smookie77/esp32PhoneV2/HARDWARE/pcb/BOM_Mainboard_PCB4_2026-01-02.csv

Quantity | Designator | Footprint | Value | Manufacturer Part | Manufacturer | Supplier Part | Supplier
8 | BOOT,GSM_DBG_RX,GSM_DBG_TX,RST,TP_BOOT,TP_DN,TP_DP,TP_VBUS | tp05R
17 | C11,C12,C31,C43,C45,C47,C51,C61,C81,C82,C83,C91,C92,C93,C94,C143,C145 | C0603 | 10uF | CL10A106KP8NNNC | SAMSUNG(三星) | C19702 | LCSC
10 | C13,C21,C22,C41,C42,C44,C46,C48,C49,C144 | C0603 | 1uF | CL10B105KA8NNNC | SAMSUNG(三星) | C29936 | LCSC
1 | C32 | C0603 | 100nF | CL10B104KC8NNNC | SAMSUNG(三星) | C15725 | LCSC
2 | C141,C142 | CAP-SMD_L7.3-W4.3-FD | 220uF | TPSD227K010R0100 | Kyocera AVX | C2764452 | LCSC
1 | CN2 | CONN-SMD_2P-P2.00_PH2.0-SPWB |  | PH-2P卧贴 | BOOMELE(博穆精密) | C47647 | LCSC
1 | H1 | HDR-TH_8P-P2.54-V-M
1 | H2 | HDR-TH_2P-P2.54-V-M-1
1 | H3 | HDR-TH_18P-P2.54-V-F-R2-C9-S2.54-1
5 | L91,L141,L142,L143,L144 | L1206 | 2.2uH | MGFL3216F2R2MT-LF | microgate(麦捷科技) | C486337 | LCSC
1 | LCD | HDR-TH_4P-P2.54-V-M
1 | LDO1 | SOT-23-5_L3.0-W1.7-P0.95-LS2.8-BL |  | ME6211C33M5G-N | MICRONE(南京微盟) | C82942 | LCSC
1 | R31 | R0603 | 680kΩ | RT0603BRE07680KL | YAGEO(国巨) | C862257 | LCSC
3 | R32,R36,R61 | R0603 | 1MΩ | RC0603FR-071ML | YAGEO(国巨) | C105578 | LCSC
5 | R41,R42,R81,R84,R85 | R0603 | 10kΩ | RT0603BRD0710KL | YAGEO(国巨) | C95204 | LCSC
3 | R43,R44,R83 | R0603 | 2kΩ | RC0603FR-072KL | YAGEO(国巨) | C105576 | LCSC
1 | R82 | R0603 | 560Ω | RT0603BRD07560RL | YAGEO(国巨) | C861472 | LCSC
1 | RF1 | IPEX-SMD_4P-L1.7-W1.7-LS2.0-L-4 | 6GHz | IPEX-3 | HanElectricity(瀚源) | C47986641 | LCSC
1 | SW1 | SW-TH_G-SWITCH_SK-12F04-G050 |  | SK-12F04-G050 | G-Switch(品赞) | C2848876 | LCSC
1 | TF1 | TF-SMD_TF-CARD-H1.8 |  | TF-CARD H1.8 | SHOU HAN(首韩) | C7529389 | LCSC
1 | U1 | WIRELM-SMD_ESP32-S3-WROOM-1U |  | ESP32-S3-WROOM-1U-N16R8 | ESPRESSIF(乐鑫) | C3013946 | LCSC
1 | U3 | TQFN-16_L3.0-W3.0-P0.50-BL-EP1.5 |  | MAX98357AETE+T | ADI(亚德诺)/MAXIM(美信) | C910544 | LCSC
1 | U4 | WQFN-20_L3.0-W3.0-P0.50-TL-EP1.4 |  | PCM1809IRTER | TI(德州仪器) | C38558044 | LCSC
1 | U5 | TSSOP-20_L6.5-W4.4-P0.65-LS6.4-BL |  | TXS0108EPWR | TI(德州仪器) | C17206 | LCSC
1 | U6 | SIM-SMD_XDSM-0240-2183B |  | XDSM-0240-2183B | LX(连欣科技) | C7498090 | LCSC
1 | U7 | USB-C-SMD_G-SWITCH_GT-USB-7010ASV |  | GT-USB-7010ASV | G-Switch(品赞) | C2988369 | LCSC
1 | U8 | MSOP-10_L3.0-W3.0-P0.50-LS5.0-BL-EP |  | BQ24090DGQR | TI(德州仪器) | C43306 | LCSC
1 | U14 | LCC-LAG_L17.6-W15.7_A7680C |  | A7680C-LANV | SIMCOM(芯讯通无线科技) | C5381968 | LCSC
