smookie77/esp32PhoneV2/HARDWARE/pcb/BOM_Keyboard_PCB3_2026-01-02.csv

No. | Quantity | Comment | Designator | Footprint | Value | Manufacturer Part | Manufacturer | Supplier Part | Supplier
1 | 21 | YZA-072-10.0 | BTN1,BTN2,BTN3,BTN4,BTN5,BTN6,BTN7,BTN8,BTN9,BTN10,BTN11,BTN12,BTN13,BTN14,BTN15,BTN16,BTN17,BTN18,BTN19,BTN20,BTN21 | SW-SMD_4P-L6.0-W6.0-P4.5-LS9.0-YZA-072-10.0 |  | YZA-072-10.0 | YIZHI(逸致) | C49108668 | LCSC
2 | 1 | 100nF | C21 | C0603 | 100nF | CL10B104KB8NNNC | SAMSUNG(三星) | C1591 | LCSC
3 | 1 | 10uF | C22 | C0603 | 10uF | CL10A106KP8NNNC | SAMSUNG(三星) | C19702 | LCSC
4 | 3 | 1uF | C31,C35,C36 | C0603 | 1uF | CL10B105KA8NNNC | SAMSUNG(三星) | C29936 | LCSC
5 | 3 | 33pF | C32,C33,C34 | C0603 | 33pF | CL10C330JB8NNNC | SAMSUNG(三星) | C1663 | LCSC
6 | 1 | PZ254V-11-08P | H1 | HDR-TH_8P-P2.54-V-M |  | PZ254V-11-08P | XFCN(兴飞) | C492407 | LCSC
7 | 3 | ST-1112RA-L | SW1,SW2,SW3 | SW-SMD_ST-1112RA-L |  | ST-1112RA-L | RISHENG(日昇) | C589179 | LCSC
8 | 1 | TCA9555RTWR | U2 | VFQFPN-24_L4.0-W4.0-P0.50-BL-EP2.8 |  | TCA9555RTWR | TI(德州仪器) | C140277 | LCSC
9 | 1 | ICS-40720 | U3 | SMD_4P-P0.88_ICS-40720 |  | ICS-40720 | TDK InvenSense(应美盛) | C3171779 | LCSC
