smookie77/esp32PhoneV2/HARDWARE/pcb/Keyboard_schematic.pdf

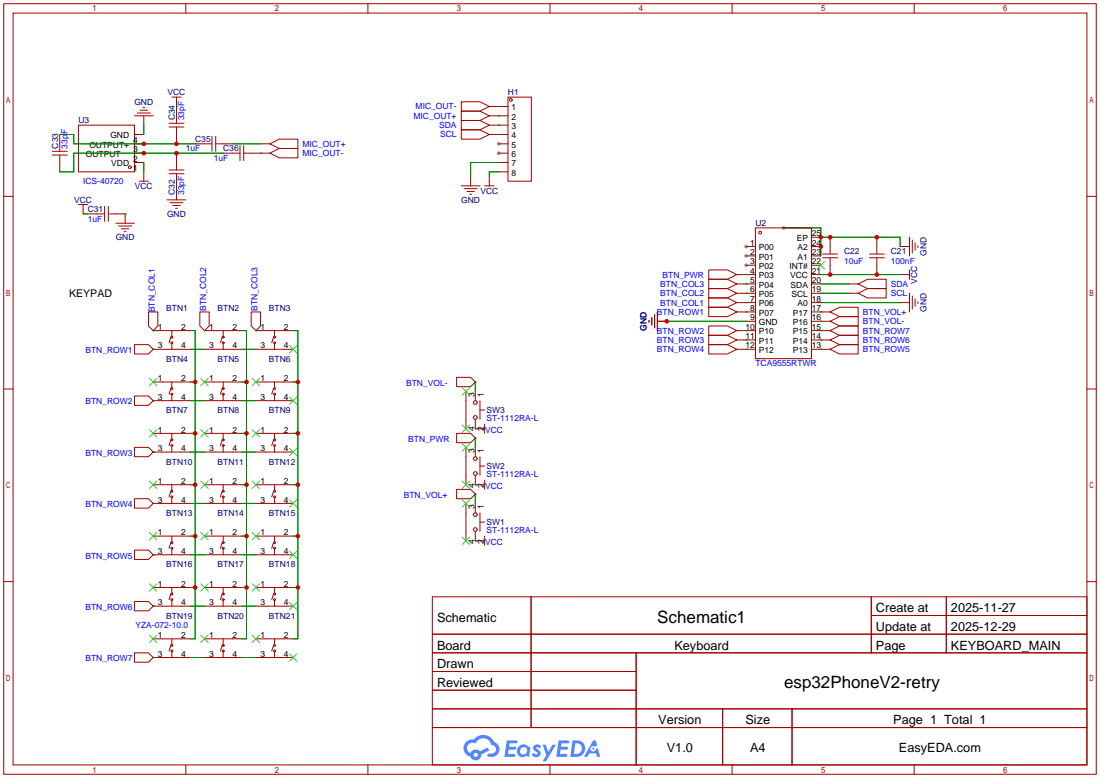
[picture p1: page 1]

Schematic | Schematic1 | Create at | 2025-11-27

Update at | 2025-12-29

Board | Keyboard | Page | KEYBOARD_MAIN
Drawn | | esp32PhoneV2-retry
Reviewed

Version | Size | Page 1 Total 1
V1.0 | A4 | EasyEDA.com
