smookie77/esp32PhoneV2/HARDWARE/pcb/Mainboard_schematics.pdf

IO0 27 IO35 28 IO36 29 IO37 30 IO38 31 IO39 32 IO40 33 IO41 34 IO42 35 RXD0 36 TXD0 37 IO2 38 IO1 39 GND 40

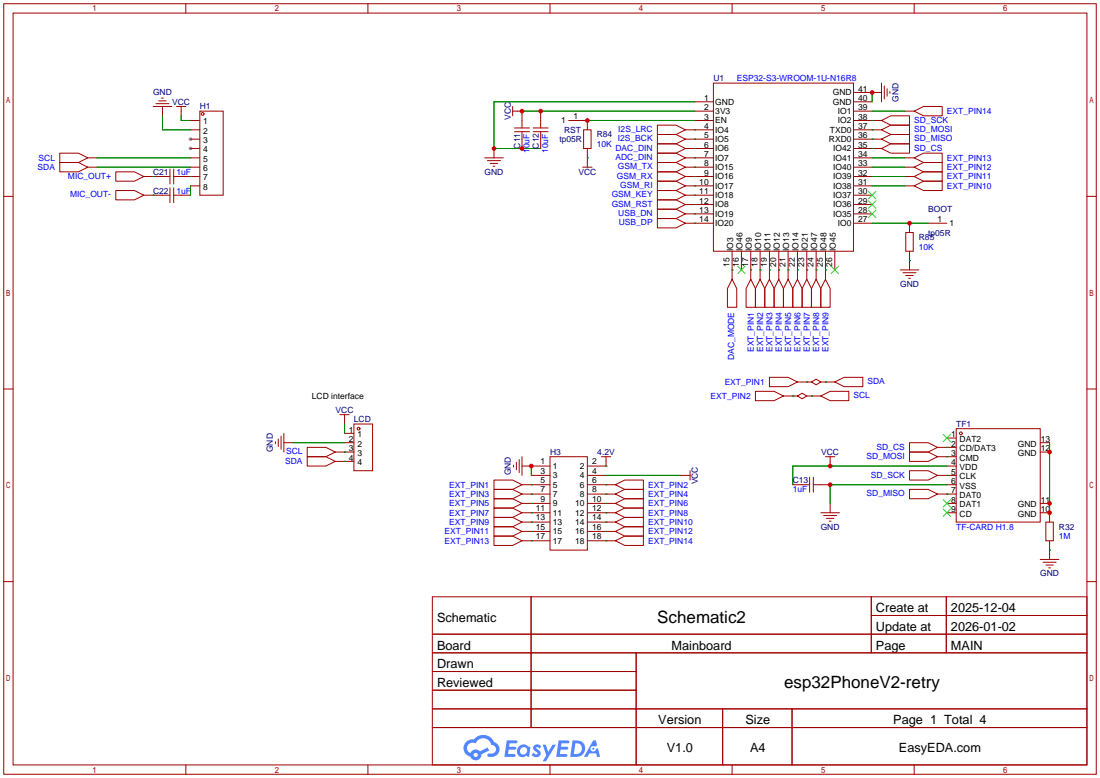
[picture p2: page 1]

Schematic | Schematic2 | Create at | 2025-12-04

Update at | 2026-01-02

Board | Mainboard | Page | MAIN
Drawn | | esp32PhoneV2-retry
Reviewed

Version | Size | Page 1 Total 4
V1.0 | A4 | EasyEDA.com

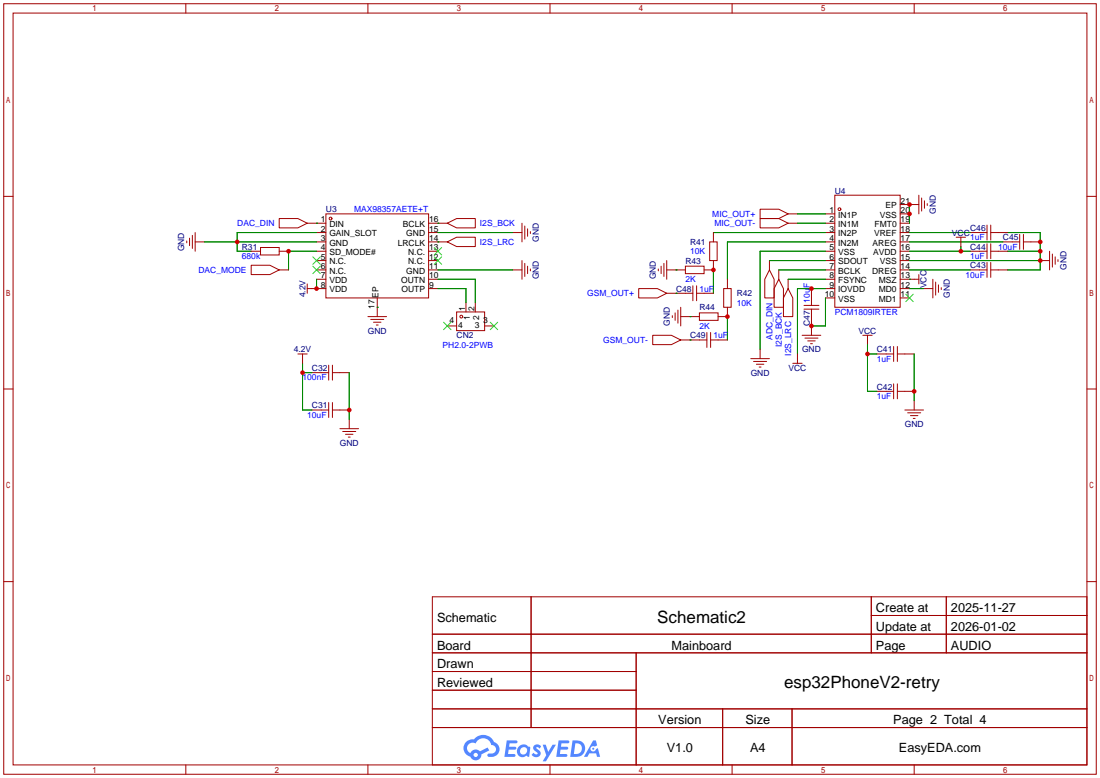
[picture p3: page 2]

OUTN 10 GND 11 N.C. 12 N.C. 13 LRCLK 14 GND 15 BCLK 16

Schematic | Schematic2 | Create at | 2025-11-27

Update at | 2026-01-02

Board | Mainboard | Page | AUDIO
Drawn | | esp32PhoneV2-retry
Reviewed

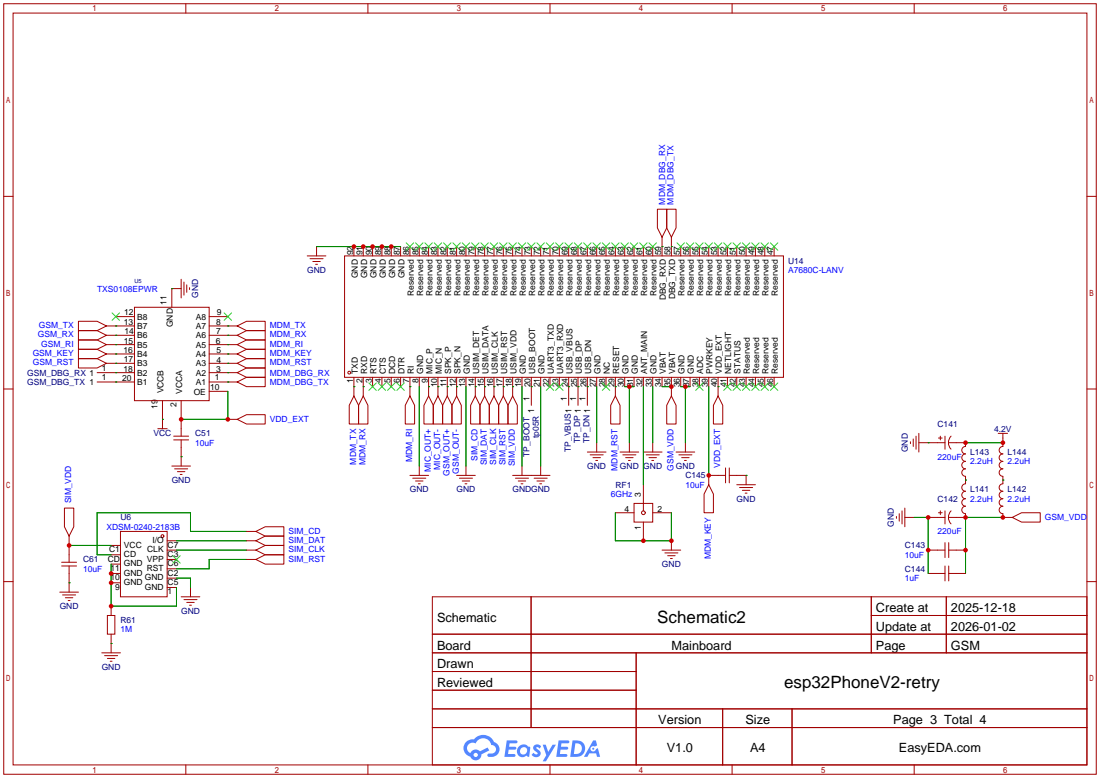
[picture p4: page 3]

Reserved 47 Reserved 46 Reserved 45 Reserved 44 Reserved 43 STATUS 42 NETLIGHT 41 VDD_EXT 40 PWRKEY 39 ADC 38 GND 37 GND 36 VBAT 35 VBAT 34 GND 33 ANT_MAIN 32 GND 31 GND 30 RESET 29 NC 28 GND 27 USB_DN 26 USB_DP 25 USB_VBUS 24 UART3_RXD 23 UART3_TXD 22 GND 21 USB_BOOT 20 GND 19 USIM_VDD 18 USIM_RST 17 USIM_CLK 16 USIM_DATA 15 USIM_DET 14 GND 13 SPK_N 12 SPK_P 11 MIC_N 10 MIC_P

I/O C7 CLK C3 VPP C6 RST C2 GND C5 GND 1

Schematic | Schematic2 | Create at | 2025-12-18

Update at | 2026-01-02

Board | Mainboard | Page | GSM
Drawn | | esp32PhoneV2-retry
Reviewed

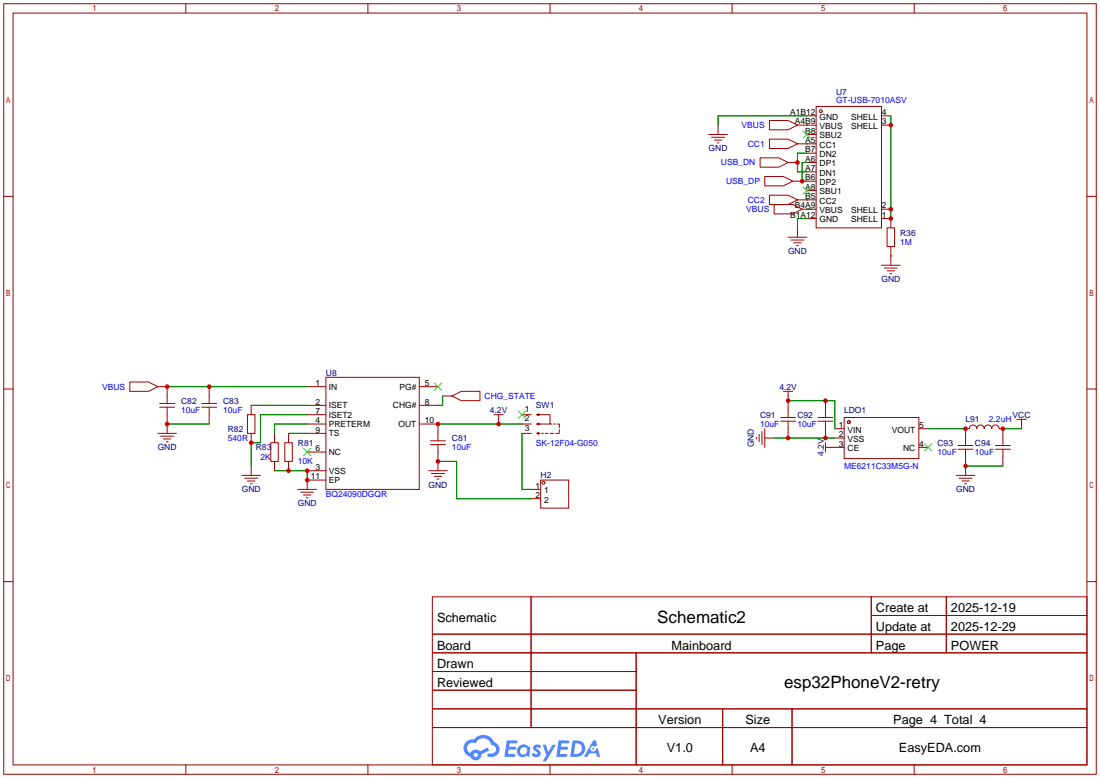
[picture p5: page 4]

SHELL 1 GND B1A12 VBUS B4A9 CC2 B5 SBU1 A8 DP2 B6 DN1 A7 DP1 A6 DN2 B7 CC1 A5 SBU2 B8 VBUS A4B9 GND A1B12

Schematic | Schematic2 | Create at | 2025-12-19

Update at | 2025-12-29

Board | Mainboard | Page | POWER
Drawn | | esp32PhoneV2-retry
Reviewed
