smookie77/esp32PhoneV2/HARDWARE/pcb/esp32PhoneV2.blockScheme.pdf

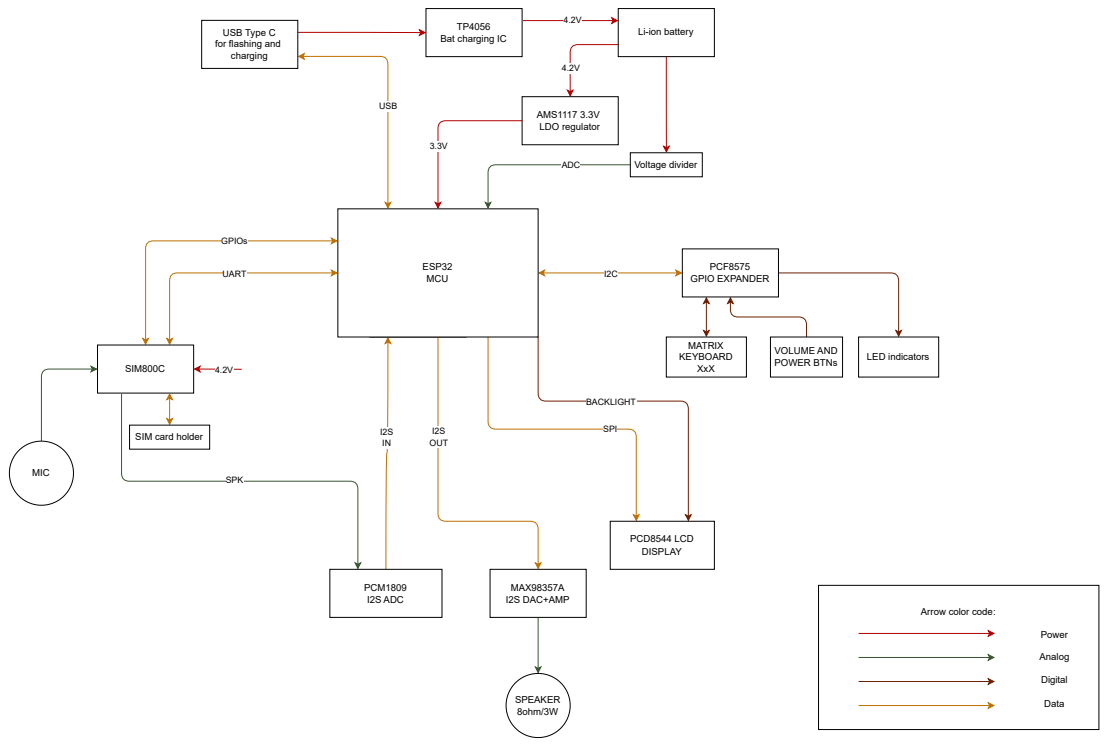
[picture p6: page 1]
ESP32-WROOM; SPI; BACKLIGHT; UART; GPIOs; I2S OUT; USB; ESP32 MCU; PCD8544 LCD DISPLAY; PCF8575 GPIO EXPANDER; MATRIX KEYBOARD XxX; VOLUME AND POWER BTNs; SPK; SIM800C; LED indicators; PCM1809 I2S ADC; MAX98357A I2S DAC+AMP; SPEAKER 8ohm/3W; MIC; Power; Analog; Digital; Data; AMS1117 3.3V LDO regulator; ADC; Voltage divider

Bat charging IC

USB Type C
for flashing and
charging

Li-ion battery

SIM card holder

Arrow color code:
