smookie77/esp32PhoneV2/HARDWARE/pcb/PCB_PCB4_2026-01-18.pdf

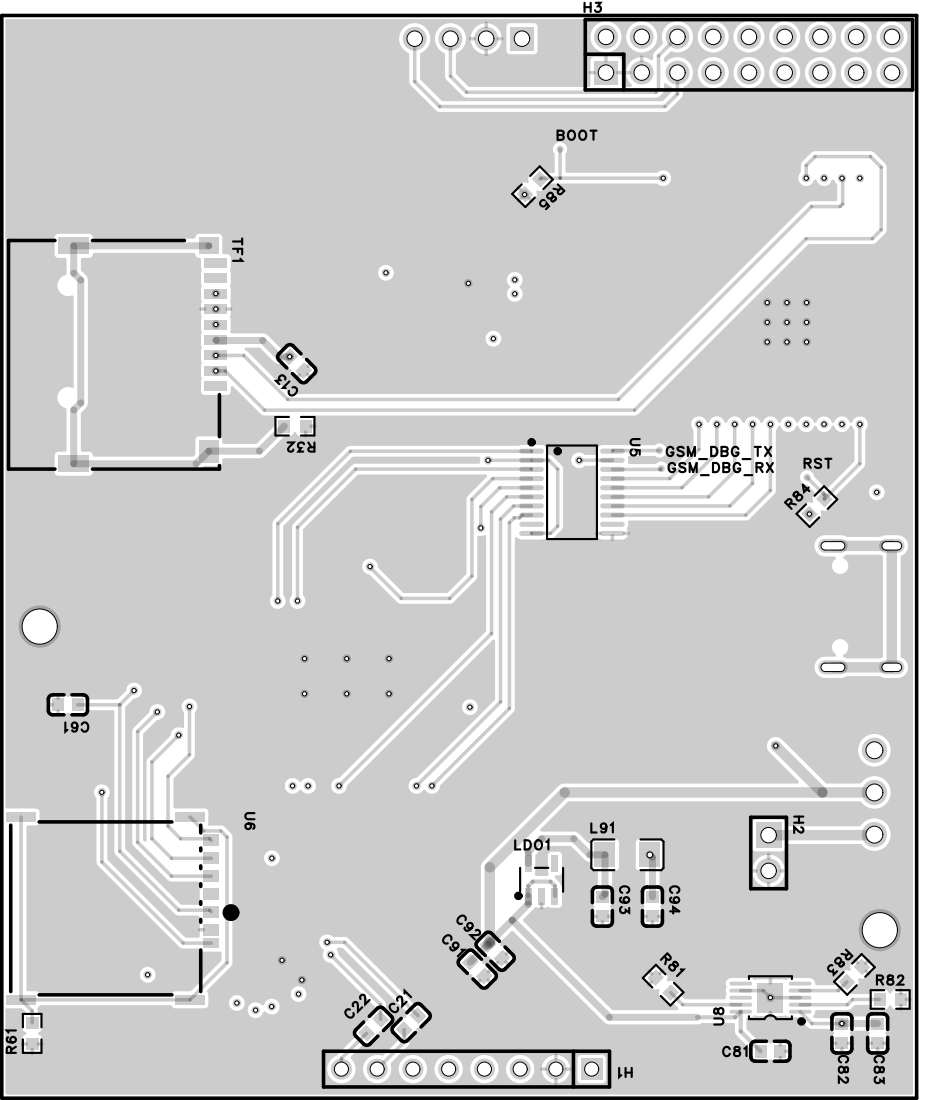
[picture p7: page 1]

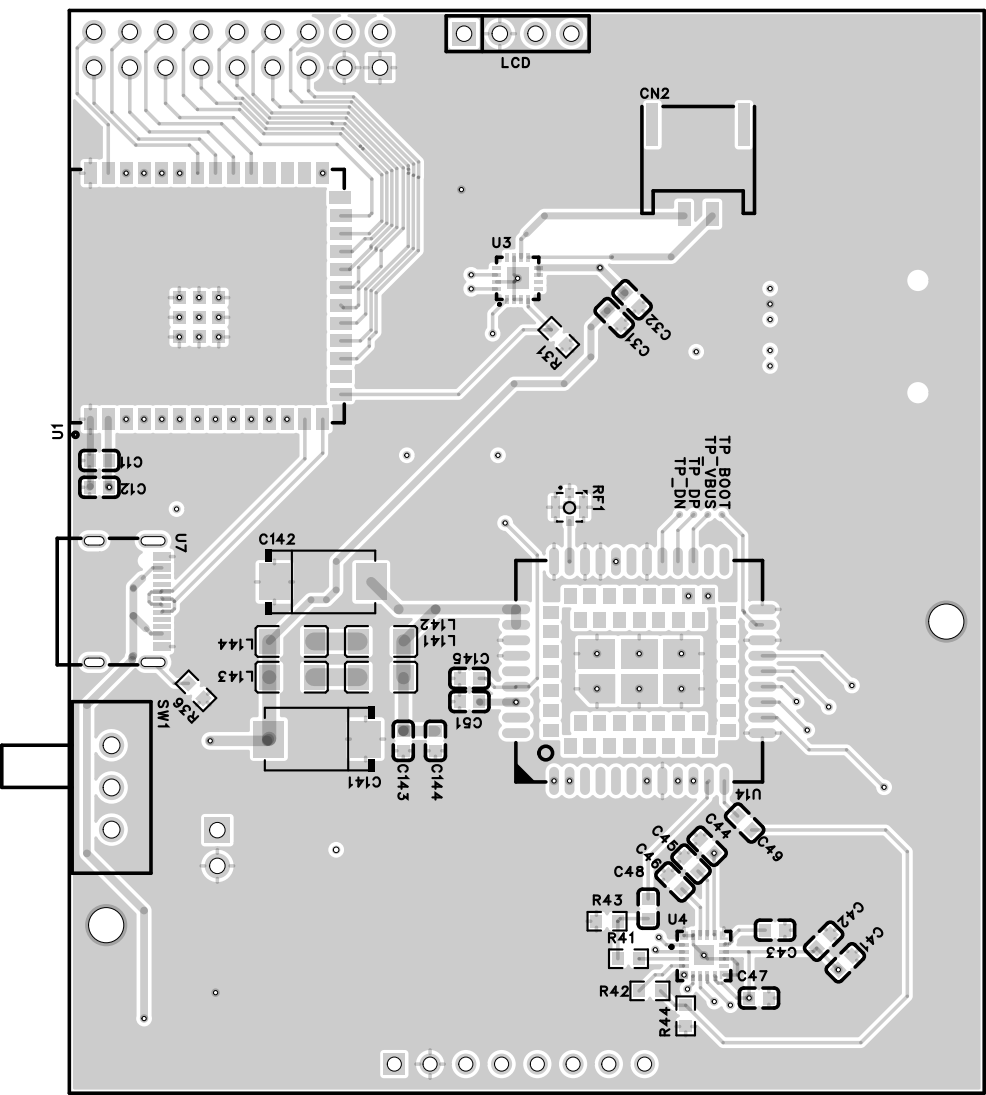
[picture p8: page 2]

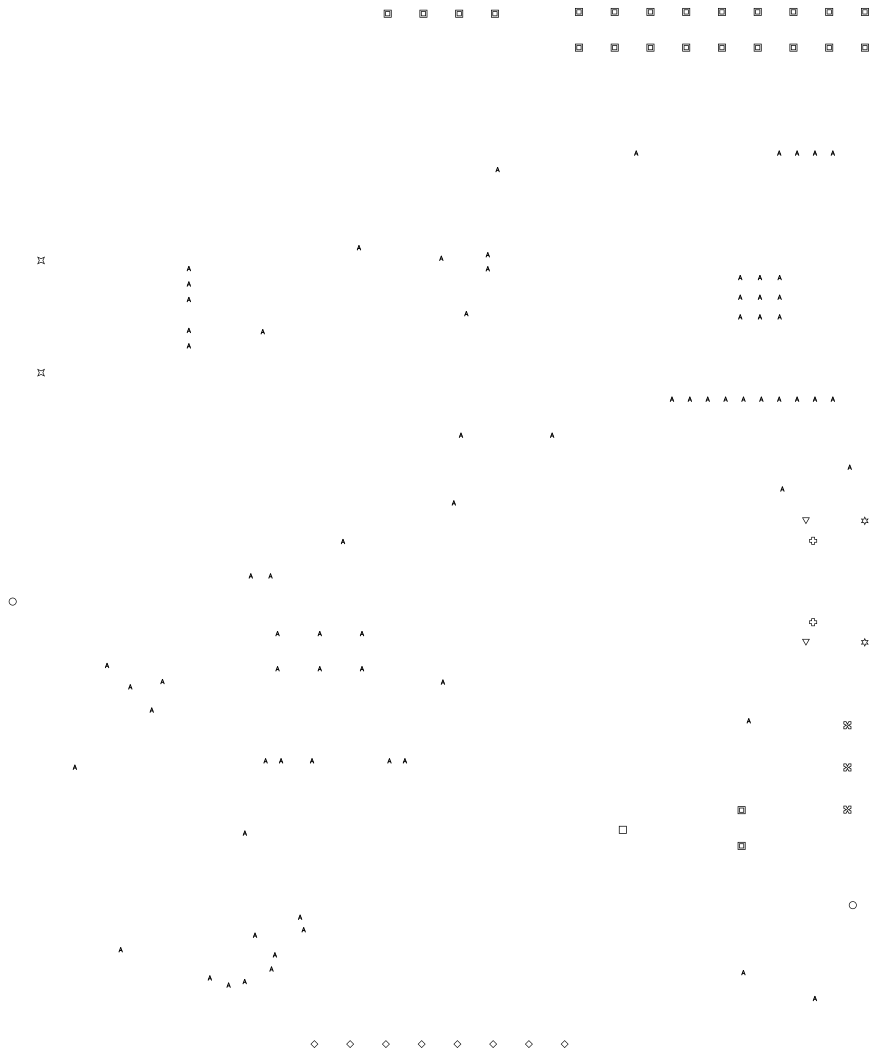
[picture p9: page 3]
