smookie77/esp32PhoneV2/(list of files, drawings)

Other design files:
HARDWARE/pcb/Keyboard.epro
HARDWARE/pcb/Mainboard.epro
