smookie77/esp32PhoneV2/(commit log)

2026-01-06 Added pcb design files and pio code
    [BOM_Keyboard_PCB3_2026-01-02.csv, BOM_Mainboard_PCB4_2026-01-02.csv, Keyboard.epro, Mainboard.epro, PickAndPlace_PCB3_2026-01-02.csv, PickAndPlace_PCB4_2026-01-02.csv]
2026-02-18 Changing folder structure
    [BOM_Keyboard_PCB3_2026-01-02.csv, BOM_Mainboard_PCB4_2026-01-02.csv, Keyboard.epro, Mainboard.epro, PickAndPlace_PCB3_2026-01-02.csv, PickAndPlace_PCB4_2026-01-02.csv]
2026-02-27 Review of PCB and starting keyboard code
